millcake666/Motoriver_RROFE_proj/pcb/IMG_5251.jpeg

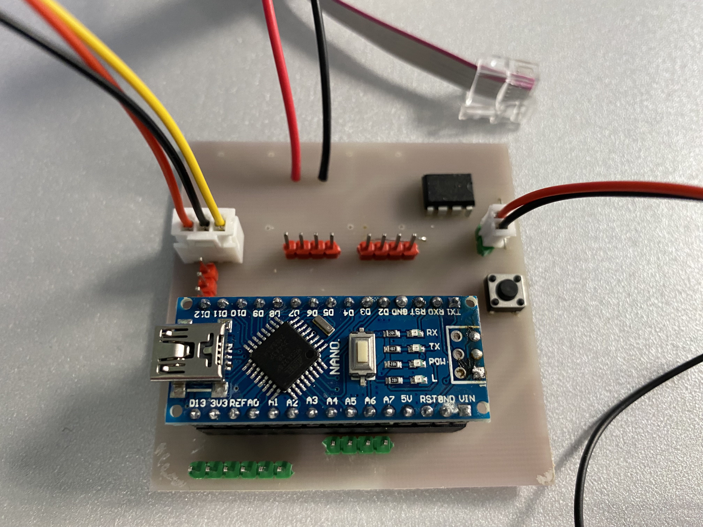
pcb/IMG_5251.jpeg
