millcake666/Motoriver_RROFE_proj/pcb/Снимок экрана 2023-06-26 в 23.53.07.png

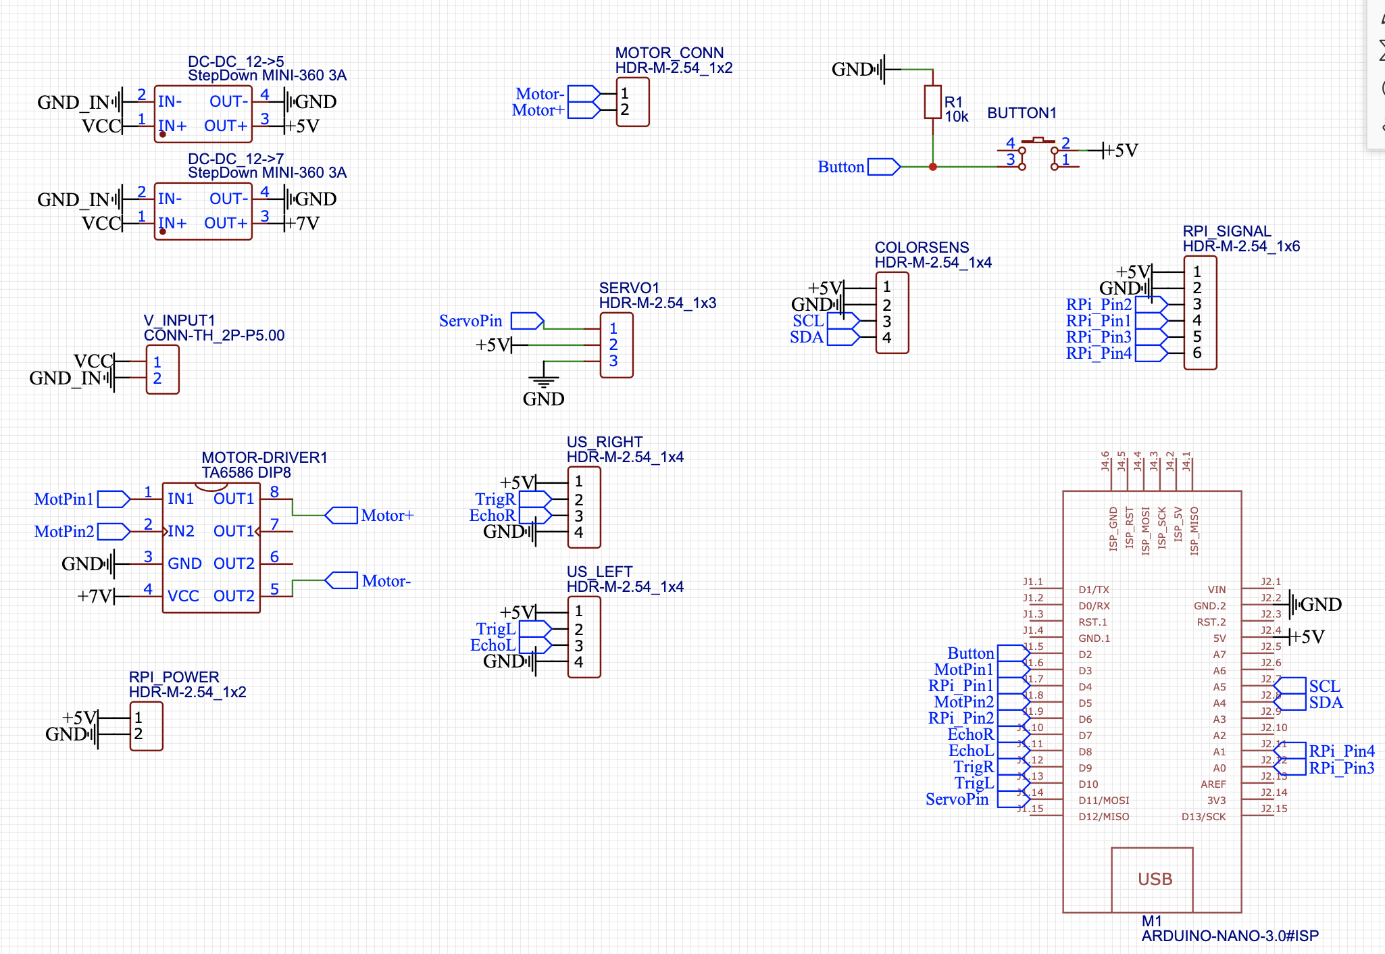
pcb/Снимок экрана 2023-06-26 в 23.53.07.png
