millcake666/Motoriver_RROFE_proj/фото робота/IMG_5365.jpeg

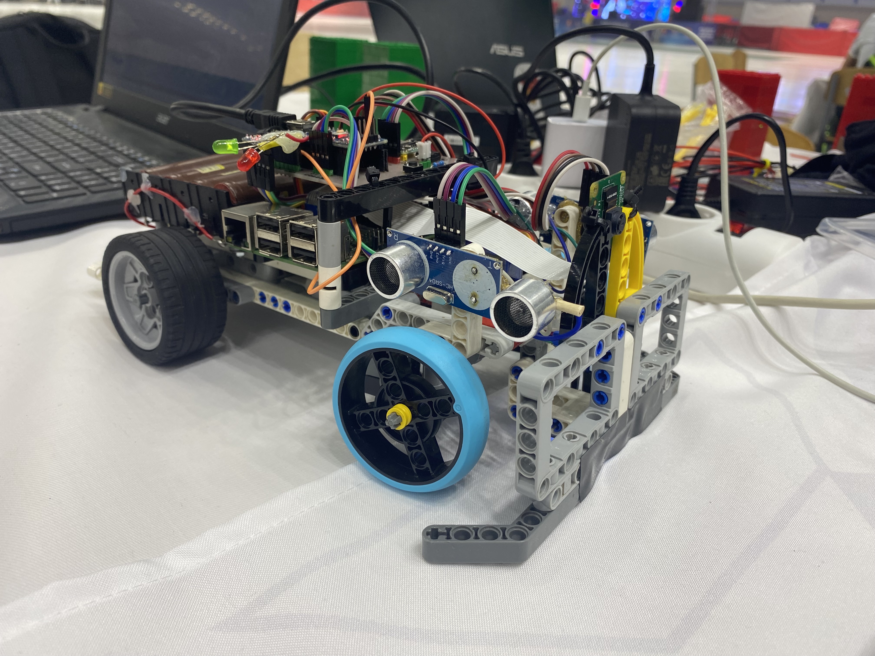
фото робота/IMG_5365.jpeg
