millcake666/Motoriver_RROFE_proj/фото робота/IMG_5371.jpeg

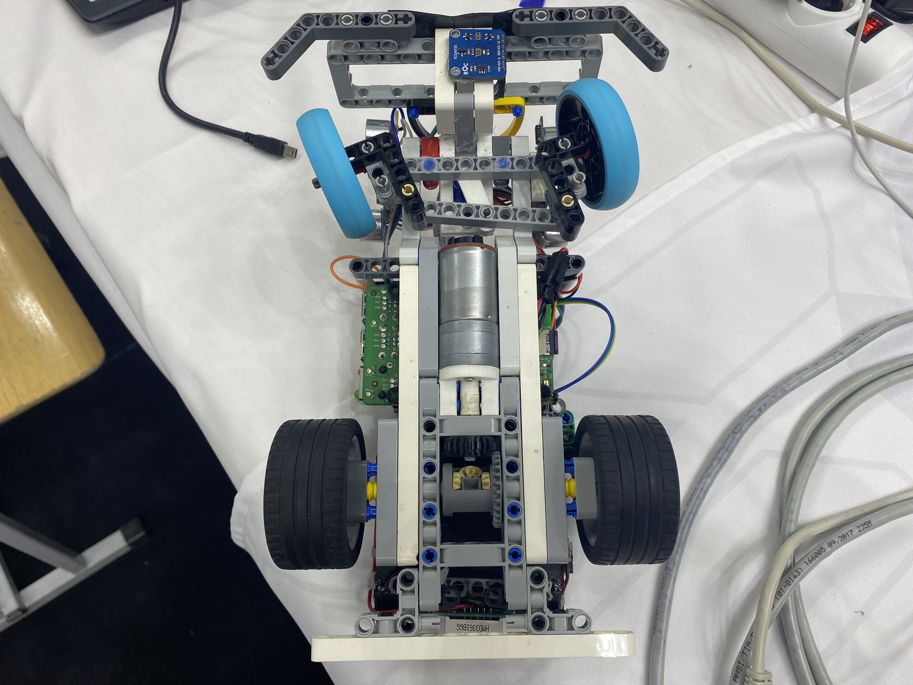
фото робота/IMG_5371.jpeg
