millcake666/Motoriver_RROFE_proj/(list of files, drawings)

Other design files:
pcb/PCB_PCB_RRO Robomobile_2023-06-15.json
pcb/SCH_RRO Robomobile_2023-06-15.json
