millcake666/Motoriver_RROFE_proj/(commit log)

2023-06-15 add pcb files
    [PCB_PCB_RRO Robomobile_2023-06-15.json, SCH_RRO Robomobile_2023-06-15.json]
2023-06-26 подгрузка финальных правок
2023-06-29 подгрузка финальных правок после отладки
