millcake666/Motoriver_RROFE_proj/pcb/IMG_5250.jpeg

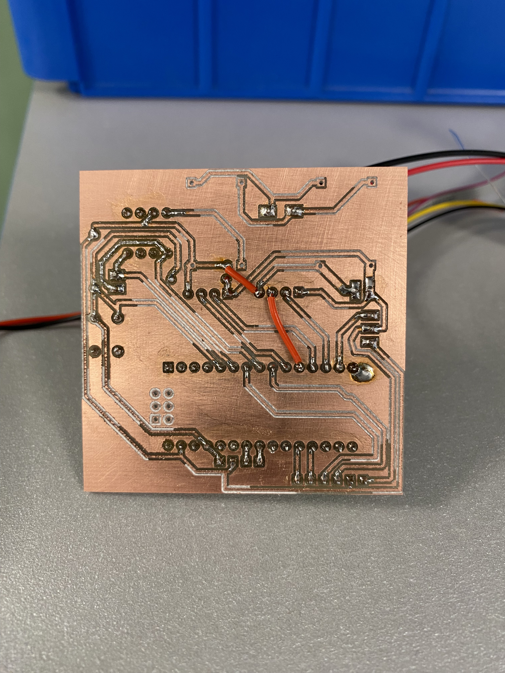
pcb/IMG_5250.jpeg
